rmoravcik/sunrise-alarmclock/README.md

Sunrise Alarm Clock

A [Philips Wake-Up Light](http://www.usa.philips.com/c-p/HF3505_60/wake-up-light) inspired alarm clock based on:

* Atmel ATmega328p
* RTC DS1307
* Bluetooth module HC-05 for remote configuration (Android application)
* WTV020 MP3 module for audio output
