rmoravcik/sunrise-alarmclock/case/dimensions.scad

wall_thickness = 2.5;

case_width = 80;
case_length = 80;
case_height = 80*1.618;

pcb_width = 48.5;
pcb_lenght = 45.25;

main_body_height = 80;
top_cover_height = 80*1.618-80;
