rmoravcik/sunrise-alarmclock/hardware/sunrise_alarmclock.brd

## EAGLE design hardware/sunrise_alarmclock.brd (2017-05-03)

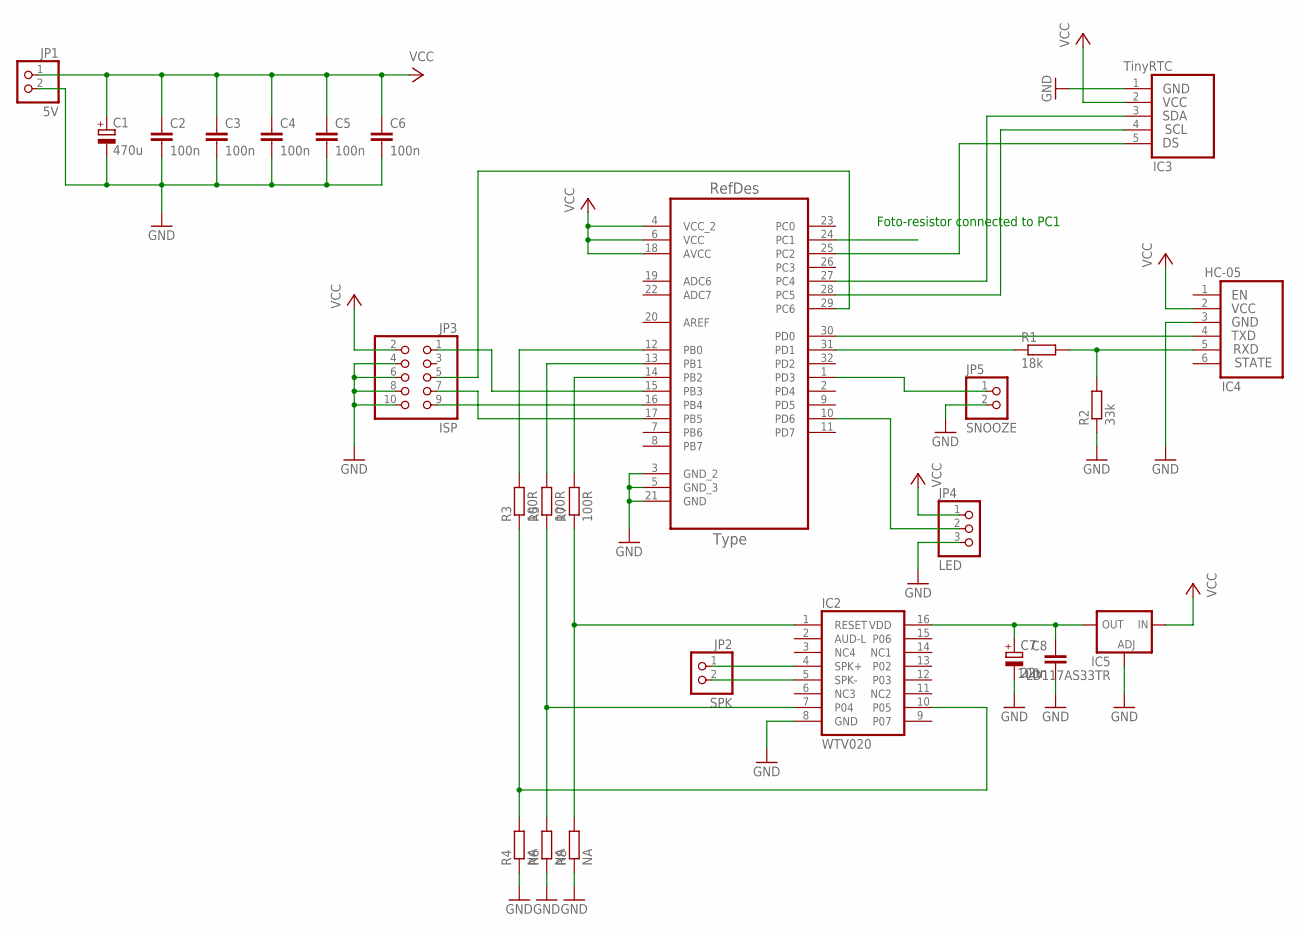
[picture p1: schematic sunrise_alarmclock.sch]

Parts:
C1: 470u; D/7343-31W
C2, C3, C4, C5, C6, C8: 100n; C1206K
C7: 22u; C/6032-28R
IC1: ATMEGA328P; QFP80P900X900X120-32N
IC2: WTV020; DIL16-6
IC3: TinyRTC; HC-05
IC4: HC-05
IC5: LD117AS33TR; SOT223
JP1: 5V; 1X02
JP2: SPK; 1X02
JP3: ISP; 2X05
JP4: LED; 1X03
JP5: SNOOZE; 1X02
R1: 18k; M1206
R2: 33k; M1206
R3, R5, R7: 100R; M1206
R4, R6, R8: NA; M1206

Connections:
GND: C1.-, C2.2, C3.2, C4.2, C5.2, C6.2, C7.-, C8.2, IC1.3 (GND_2), IC1.5 (GND_3), IC1.21 (GND), IC2.8 (GND), IC3.1 (GND), IC4.3 (GND), IC5.1 (ADJ), JP1.2, JP3.4, JP3.6, JP3.8, JP3.10, JP4.3, JP5.2, R2.1, R4.1, R6.1, R8.1
unnamed: IC1.15 (PB3), JP3.1
unnamed: IC1.29 (PC6), JP3.5
unnamed: IC1.17 (PB5), JP3.7
unnamed: IC1.16 (PB4), JP3.9
unnamed: IC1.31 (PD1), R1.1
unnamed: IC4.5 (RXD), R1.2, R2.2
unnamed: IC2.4 (SPK+), JP2.1
unnamed: IC1.28 (PC5), IC3.4 (SCL)
unnamed: IC1.27 (PC4), IC3.3 (SDA)
unnamed: IC2.5 (SPK-), JP2.2
unnamed: IC2.1 (RESET), R7.1, R8.2
unnamed: IC1.30 (PD0), IC4.4 (TXD)
unnamed: IC2.7 (P04), R5.1, R6.2
unnamed: IC2.10 (P05), R3.1, R4.2
unnamed: IC1.12 (PB0), R3.2
unnamed: IC1.25 (PC2), IC3.5 (DS)
unnamed: C7.+, C8.1, IC2.16 (VDD), IC5.4 (OUT)
unnamed: IC1.13 (PB1), R5.2
unnamed: IC1.14 (PB2), R7.2
unnamed: IC1.10 (PD6), JP4.2
unnamed: IC1.1 (PD3), JP5.1
VCC: C1.+, C2.1, C3.1, C4.1, C5.1, C6.1, IC1.4 (VCC_2), IC1.6 (VCC), IC1.18 (AVCC), IC3.2 (VCC), IC4.2 (VCC), IC5.3 (IN), JP1.1, JP3.2, JP4.1

Notes on the sheet:
Foto-resistor connected to PC1

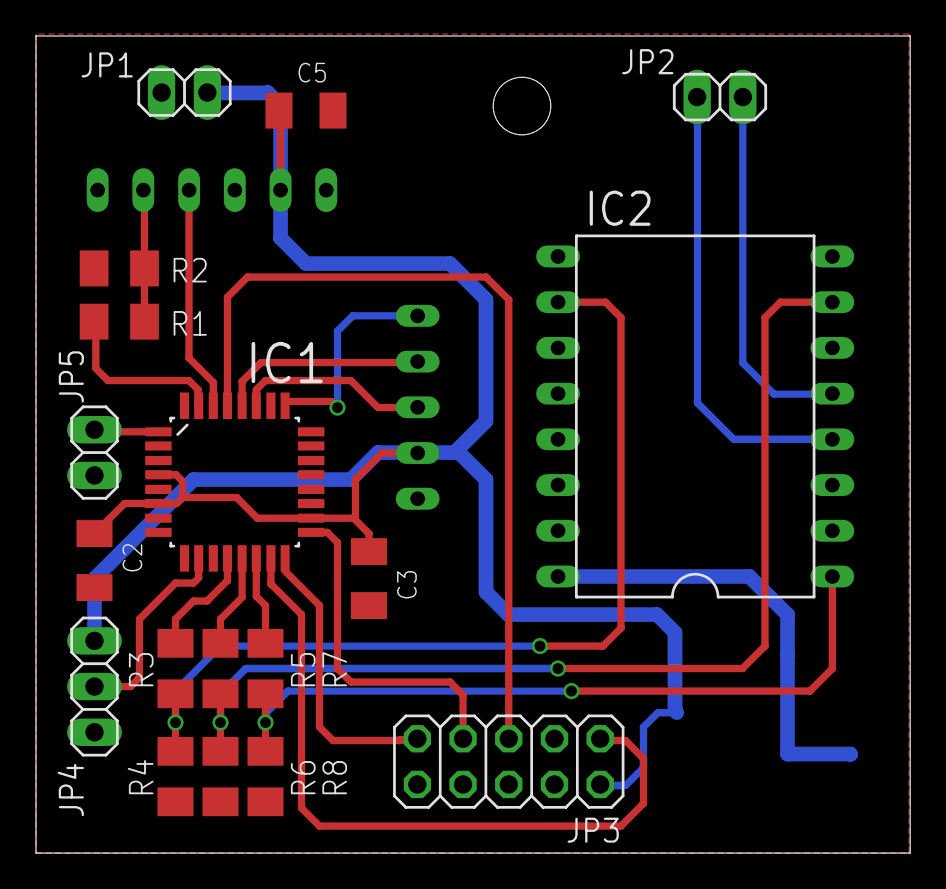
[picture p2: board sunrise_alarmclock.brd from above]

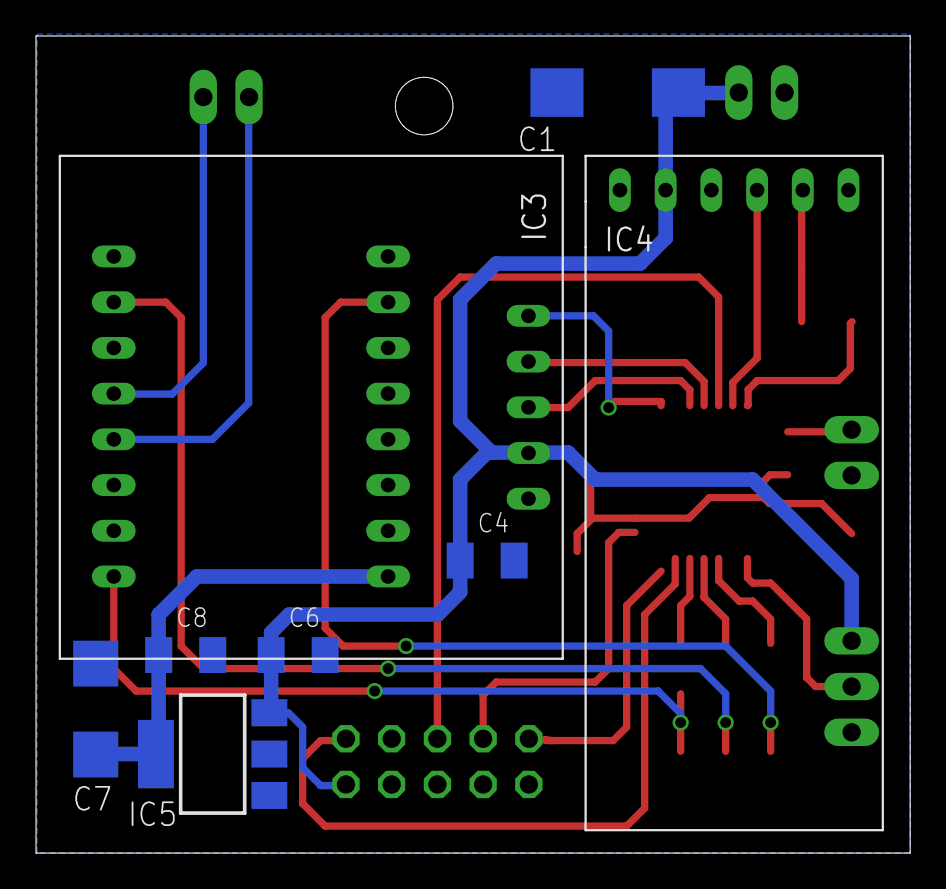
[picture p3: board sunrise_alarmclock.brd from below]

Board: 2 copper layers, 48.6 x 45.4 mm, 26 parts (8 on the bottom side), 23 nets.
