rmoravcik/sunrise-alarmclock/firmware/led.c

/*
 *  sunrise-alarmclock
 *  Copyright (C) 2016,2017 Roman Moravcik
 *
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
 *  You should have received a copy of the GNU General Public License
 *  along with this program; if not, write to the Free Software
 *  Foundation, Inc., 59 Temple Place, Suite 330, Boston, MA  02111-1307  USA
 */

#include <stdio.h>

#include "ds_rtc_lib/library-gcc/test/uart.h"
#include "light_ws2812/light_ws2812_AVR/Light_WS2812/light_ws2812.h"

#include "common.h"

#include "led.h"

#define NUM_LEDS 7

#define SUNRISE_INTERVAL (TO_PERIOD(PREALARM_RUNNING_MIN) / 4)
#define SUNSET_FADEIN_INTERVAL (20)
#define SUNSET_FADEOUT_INTERVAL (20)
#define SUNSET_INTERVAL (TO_PERIOD(ALARM_TIMEOUT_MIN))

#define NIGHT_LAMP_INTENSITY 255

static uint8_t red_max = 255;
static uint8_t green_max = 150;
static uint8_t blue_max = 150;

struct cRGB leds[NUM_LEDS];

void led_init(void)
{
    led_off();
}

void led_sunrise(uint16_t period)
{
    uint8_t red = 0, green = 0, blue = 0;
    uint8_t i = 0;
#ifdef DEBUG
    char buf[60];
#endif

    if ((period >= 0) && (period < SUNRISE_INTERVAL)) {
        red = ((uint32_t)period + 1) * 20 / SUNRISE_INTERVAL;
        green = ((uint32_t)period + 1) * 2 / SUNRISE_INTERVAL;
        blue = 0;
    } else if ((period >= SUNRISE_INTERVAL) && (period < (2 * SUNRISE_INTERVAL))) {
        red = 20 + (((uint32_t)period - SUNRISE_INTERVAL + 1) * 30 / SUNRISE_INTERVAL);
        green = 2 + (((uint32_t)period - SUNRISE_INTERVAL + 1) * 18 / SUNRISE_INTERVAL);
        blue = 0;
    } else if ((period >= (2 * SUNRISE_INTERVAL)) && (period < (3 * SUNRISE_INTERVAL))) {
        red = 50 + (((uint32_t)period - (2 * SUNRISE_INTERVAL) + 1) * 77 / SUNRISE_INTERVAL);
        green = 20 + (((uint32_t)period - (2 * SUNRISE_INTERVAL) + 1) * 31 / SUNRISE_INTERVAL);
        blue = ((uint32_t)period - (2 * SUNRISE_INTERVAL) + 1) * 11 / SUNRISE_INTERVAL;
    } else if ((period >= (3 * SUNRISE_INTERVAL)) && (period < (4 * SUNRISE_INTERVAL))) {
        red = 127 + (((uint32_t)period - (3 * SUNRISE_INTERVAL) + 1) * (red_max - 127) / SUNRISE_INTERVAL);
        green = 51 + (((uint32_t)period - (3 * SUNRISE_INTERVAL) + 1) * (green_max - 51) / SUNRISE_INTERVAL);
        blue = 11 + (((uint32_t)period - (3 * SUNRISE_INTERVAL) + 1) * (blue_max - 11) / SUNRISE_INTERVAL);
    } else if (period >= (4 * SUNRISE_INTERVAL)) {
        red = red_max;
        green = green_max;
        blue = blue_max;
    }

#ifdef DEBUG
    if (debug & DEBUG_LED) {
        sprintf(buf, "led_sunrise: period=%4u, rgb(%03u,%03u,%03u)\r\n",
                period, red, green, blue);
        uartSendString(buf);
    }
#endif

    for (i = 0; i < NUM_LEDS; i++) {
        leds[i].r = red;
        leds[i].g = green;
        leds[i].b = blue;
    }

    ws2812_setleds(leds, NUM_LEDS);
}

void led_sunset(uint16_t period)
{
    static uint8_t red_init = 0, green_init = 0, blue_init = 0;
    uint8_t red = 0, green = 0, blue = 0;
    uint8_t i = 0;
#ifdef DEBUG
    char buf[60];
#endif

    if (period == 0) {
        red_init = leds[0].r;
        green_init = leds[0].g;
        blue_init = leds[0].b;
    }

    if ((period >= 0) && (period < SUNSET_FADEIN_INTERVAL)) {
        red = red_init + (((uint32_t)period + 1) * (red_max - red_init) / SUNSET_FADEIN_INTERVAL);
        green = green_init + (((uint32_t)period + 1) * (green_max - green_init) / SUNSET_FADEIN_INTERVAL);
        blue = blue_init + (((uint32_t)period + 1) * (blue_max - blue_init) / SUNSET_FADEIN_INTERVAL);
    } else if ((period >= 3) && (period <= (SUNSET_INTERVAL - SUNSET_FADEOUT_INTERVAL))) {
        red = red_max;
        green = green_max;
        blue = blue_max;
    } else if ((period >= (SUNSET_INTERVAL - SUNSET_FADEOUT_INTERVAL)) &&
               (period < SUNSET_INTERVAL)) {
        red = red_max - (((uint32_t)period - SUNSET_INTERVAL + SUNSET_FADEOUT_INTERVAL + 1) *
                red_max / SUNSET_FADEOUT_INTERVAL);
        green = green_max - (((uint32_t)period - SUNSET_INTERVAL + SUNSET_FADEOUT_INTERVAL + 1) *
                green_max / SUNSET_FADEOUT_INTERVAL);
        blue = blue_max - (((uint32_t)period - SUNSET_INTERVAL + SUNSET_FADEOUT_INTERVAL + 1) *
                blue_max / SUNSET_FADEOUT_INTERVAL);
    } else {
        red = 0;
        green = 0;
        blue = 0;
    }

#ifdef DEBUG
    if (debug & DEBUG_LED) {
        sprintf(buf, "led_sunset: period=%4u, rgb(%03u,%03u,%03u)\r\n",
                period, red, green, blue);
        uartSendString(buf);
    }
#endif

    for (i = 0; i < NUM_LEDS; i++) {
        leds[i].r = red;
        leds[i].g = green;
        leds[i].b = blue;
    }

    ws2812_setleds(leds, NUM_LEDS);
}

void led_on(void)
{
    uint8_t i = 0;

    for (i = 0; i < NUM_LEDS; i++) {
        leds[i].r = red_max;
        leds[i].g = green_max;
        leds[i].b = blue_max;
    }

    ws2812_setleds(leds, NUM_LEDS);
}

void led_off(void)
{
    uint8_t i = 0;

    for (i = 0; i < NUM_LEDS; i++) {
        leds[i].r = 0;
        leds[i].g = 0;
        leds[i].b = 0;
    }

    ws2812_setleds(leds, NUM_LEDS);
}

void led_night_lamp(void)
{
    uint8_t i = 0;

    for (i = 0; i < NUM_LEDS; i++) {
        leds[i].r = NIGHT_LAMP_INTENSITY;
        leds[i].g = NIGHT_LAMP_INTENSITY;
        leds[i].b = NIGHT_LAMP_INTENSITY;
    }

    ws2812_setleds(leds, NUM_LEDS);
}

#ifdef DEBUG
void led_set(uint8_t red, uint8_t green, uint8_t blue)
{
    uint8_t i = 0;

    for (i = 0; i < NUM_LEDS; i++) {
        leds[i].r = red;
        leds[i].g = green;
        leds[i].b = blue;
    }

    ws2812_setleds(leds, NUM_LEDS);
}
#endif
