rmoravcik/sunrise-alarmclock/(commit log)

2016-10-26 Added prototype hardware design.
    [sunrise_alarmclock.brd, sunrise_alarmclock.sch]
2016-10-29 client: fixed communication with hw
    [command.c]
2016-10-30 client: removed debugging code. make switch disabled by default.
2016-11-01 firmware: switch to internal 8MHz RC oscilator.
2016-11-02 client: fixed connection to device. added a connecting dialog.
2016-11-03 firmware: try to set prealarm/alarm on device startup.
2016-11-03 firmware: fixed setting/clearing alarm by command
    [main.c]
2016-11-03 firmware: removed useless debug print. invoke ISR for PC2 every 1sec instead of 500ms
2016-11-03 firmware: fixed period calculation
    [common.h, led.c, main.c]
2016-11-03 firmware: added function to calc next wday. fixed reset of alarms during startup.
    [main.c]
2016-11-03 firmware: fixed macro TO_SEC(). improved sunset effect
    [common.h]
2016-11-04 firmware: update leds every 500ms instead of 1 sec.
2016-11-04 firmware: added debug command to control leds.
2016-11-05 hardware: added components values
    [sunrise_alarmclock.brd, sunrise_alarmclock.sch]
2016-11-22 firmware: turn on display for a 10 seconds after button press or during the alarm
2016-11-23 firmware: fix blinking of display during of alarm.
    [main.c]
2016-11-27 firmware: play alarm twice. fixed alarm volume.
    [common.h, main.c]
2016-11-27 firmware: do not turn on leds if alarm is going to be turn on without prealarm.
2017-02-20 firmware: Fixed clearing of alarm if alarm on the next day is off.
    [common.h, main.c]
2017-02-21 firmware: Added a simple light sensor.
2017-02-21 firmware: Check update of display every 500ms to speed up response to button press.
2017-02-28 firmware: short press of button will stop prealarm and alarm immediately.
    [common.h, led.c, main.c]
2017-02-28 case: added top_cover of case.
    [dimensions.scad, rounded_cube.scad, top_cover.scad]
2017-02-28 case: added bottom_cover.
    [bottom_cover.scad, dimensions.scad]
2017-03-01 case: added led_holder.
    [led_holder.scad]
2017-03-01 case: working version of main_body of case.
    [dimensions.scad, main_body.scad, top_cover.scad]
2017-03-12 firmware: fixed alarm starting at midnight. Manual snooze button replaced by touch sensor with TTP223b.
    [main.c, rtc_wrapper.c]
2017-03-18 case: added speaker holder. fixed led_holder. main_body optimization.
    [led_holder.scad, main_body.scad, speaker_holder.scad]
2017-03-18 case: main_body translation
    [main_body.scad]
2017-04-19 firmware: fixed update of clock after alarm timeout
    [main.c]
2017-04-19 fixmware: fixed captive portal. added reconnection to network if again available.
    [Page_NTPSettings.h, Page_NetworkConfiguration.h, common.h, config.cpp, config.h, esp_webconfig.ino, helpers.cpp, helpers.h]
2017-04-24 firmware: added and fixed calculation of local time from ntp timestamp.
    [Page_Information.h, Page_NetworkConfiguration.h, esp_webconfig.ino, helpers.cpp, ntp.cpp, ntp.h]
2017-05-03 hardware: fixed values of resistor towards the voice module. added note about connection of photo resistor to pin PC1
    [sunrise_alarmclock.brd, sunrise_alarmclock.sch]
2019-01-02 Print debug only when WIFI status changed.
2019-01-03 Log shortcut added to main configuration page.
    [Page_Configuration.h]
2019-01-03 Fixed Wifi logging with SERIAL_DEBUG disabled.
    [esp_webconfig.ino]
